HotPixelChannel/FamicomWirelessController/(threads)

Thread 1 (2024-01-09):

Проблема с gerber файлом при заказе на jlcpcb.com

Bipyc13, 2024-01-09:
При заказе изготовления платы на jlcpcb.com, gerber файл не прошел аудит с комментарием:

Audit failure reason:

1.Hi Sir/ Madam, Sorry to tell you that your PCB is not big enough to make with v-cut since its size is less than 70*70mm and it can not get through the v-cut machine. You can click ‘Replace file’ button to re-upload the file in your JLCPCB account page .Thanks

Как фикс предлагаю сделать отдельные gerber файлы для джойстика и пириемника или обьеденить 2 набора джойстика и приемника в 1 файл чтобы увиличить размер платы
