HotPixelChannel/FamicomWirelessController/Hardware/Schematic.pdf

## BT_UP

## BT_DWN

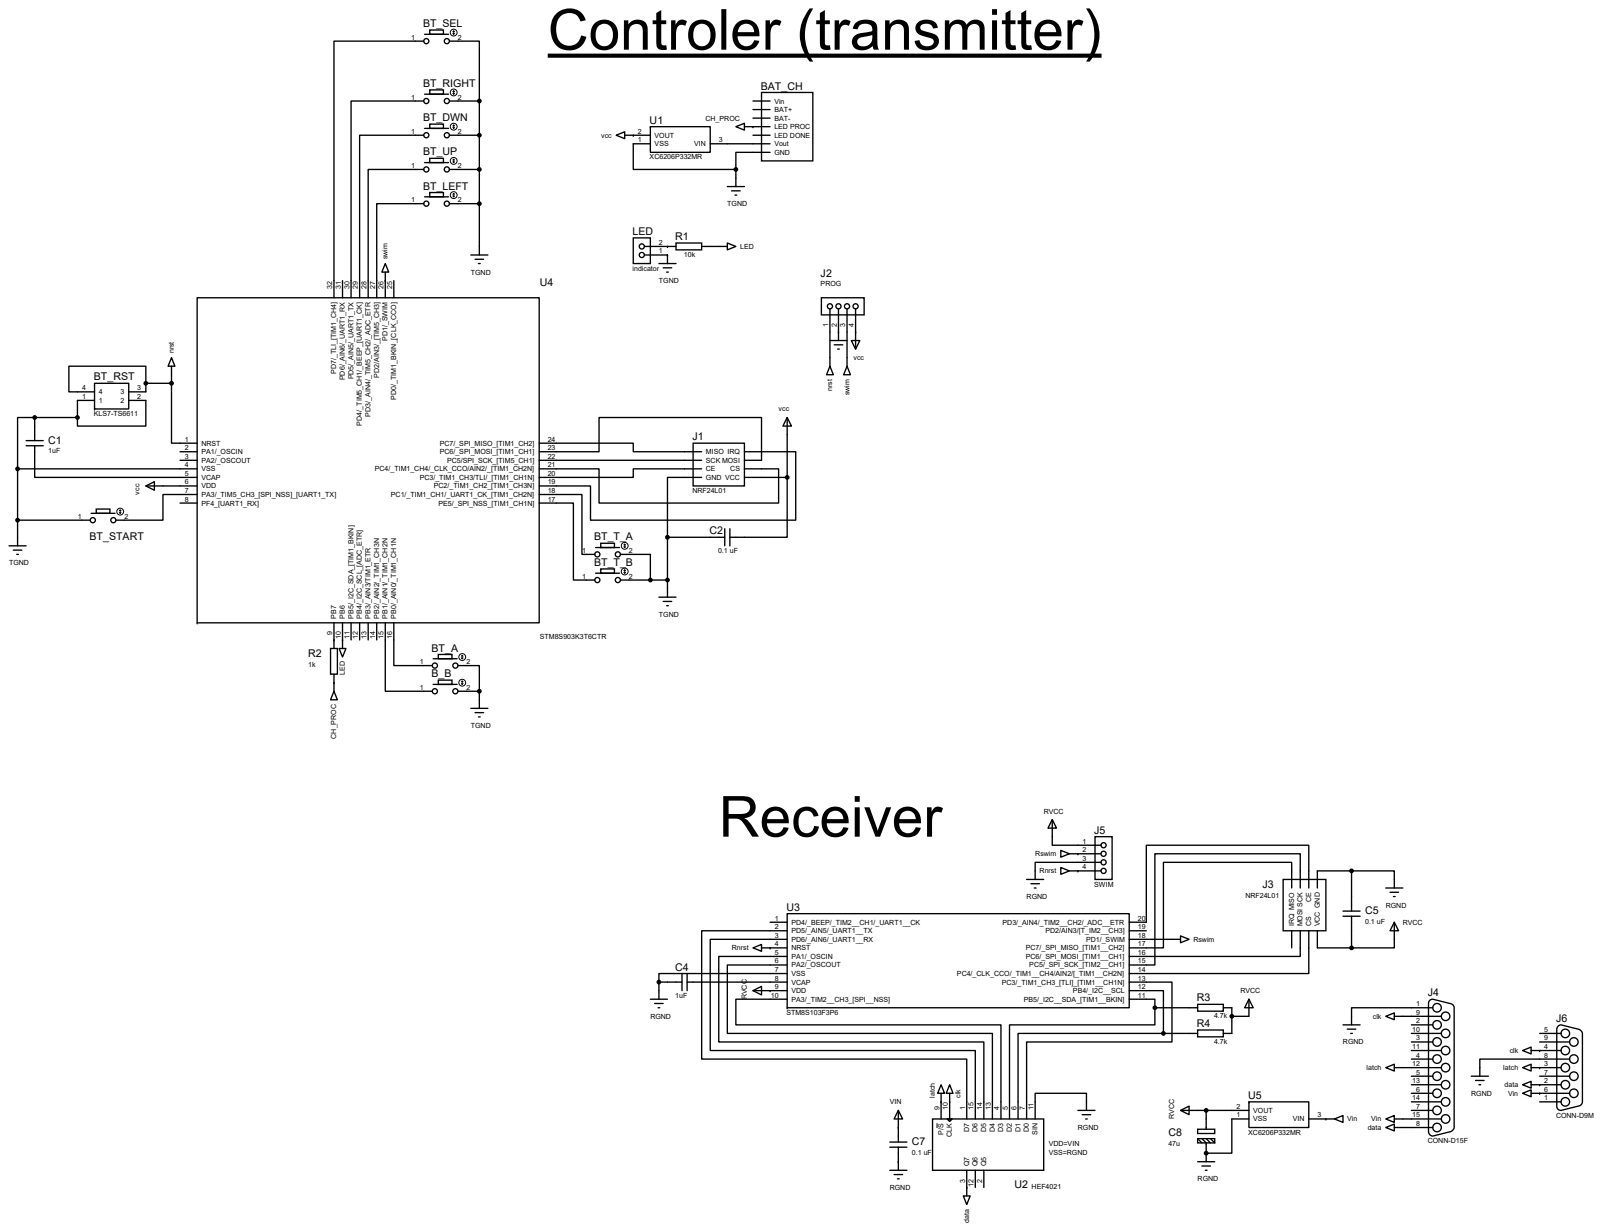
[picture p1: page 1]
